cameronl/power-wedge-control-pcb-kicad/bom/rev1/power-wedge-control.ods

Source: | /Users/cameronl/Documents/dev/pcb-kicad/power-wedge-control/power-wedge-control.kicad_sch
Date: | Wednesday, February 23, 2022 at 02:38:49 PM
Tool: | Eeschema (6.0.2-0)
Generator: | /Applications/KiCad/KiCad.app/Contents/SharedSupport/plugins/bom_csv_grouped_by_value_with_fp.py
Component Count: | 90
Ref | Qnty | Value | Cmp name | Footprint | Description | Vendor
C1, C2, | 2 | 470n | C | Capacitor_SMD:C_0603_1608Metric | Unpolarized capacitor
C3, C4, | 2 | NOSTUFF | C | Capacitor_SMD:C_0603_1608Metric | Unpolarized capacitor
C5, C7, C14, | 3 | 10u | C | Capacitor_SMD:C_1206_3216Metric | Unpolarized capacitor
C6, C8, C13, C15, C16, | 5 | 100n | C | Capacitor_SMD:C_0603_1608Metric | Unpolarized capacitor
C9, C10, C11, C12, | 4 | 1uF | C | Capacitor_SMD:C_0603_1608Metric | Unpolarized capacitor
D1, D2, D3, D4, | 4 | LL4148 | D | Diode_SMD:D_MiniMELF | Diode
L1, L2, L3, | 3 | 600R/200mA | L | Inductor_SMD:L_0603_1608Metric | Inductor
LED1, LED2, | 2 | LED | LED | LED_SMD:LED_0603_1608Metric | Light emitting diode
LED3, LED4, | 2 | LED_GRN | LED | LED_SMD:LED_0603_1608Metric | Light emitting diode
Q1, Q3, Q5, Q6, | 4 | MMBT3904L | Q_NPN_BEC | Package_TO_SOT_SMD:SOT-23 | NPN transistor, base/emitter/collector
Q2, Q4, | 2 | DMP3099L | Q_PMOS_GSD | Package_TO_SOT_SMD:SOT-23 | P-MOSFET transistor, gate/source/drain
R1, R4, R11, R12, | 4 | 10k | R | Resistor_SMD:R_0603_1608Metric | Resistor
R2, R5, R9, R10, R13, R14, R21, R22, | 8 | 1k | R | Resistor_SMD:R_0603_1608Metric | Resistor
R3, R6, | 2 | 100k | R | Resistor_SMD:R_0603_1608Metric | Resistor
R7, R8, R23, | 3 | 200k | R | Resistor_SMD:R_0603_1608Metric | Resistor
R15, R17, | 2 | 6.8k | R | Resistor_SMD:R_0603_1608Metric | Resistor
R16, R18, | 2 | 8.2k | R | Resistor_SMD:R_0603_1608Metric | Resistor
R19, R20, R24, | 3 | 4k7 | R | Resistor_SMD:R_0603_1608Metric | Resistor
R25, | 1 | 470 | R | Resistor_SMD:R_0603_1608Metric | Resistor
U1, | 1 | LM1117-5.0 | LM1117-5.0 | Package_TO_SOT_SMD:TO-252-2 | 800mA Low-Dropout Linear Regulator, 5.0V fixed output, TO-220/TO-252/TO-263/SOT-223
U2, U9, | 2 | NC7WZ14P6X | NC7WZ14P6X | Package_TO_SOT_SMD:SOT-363_SC-70-6 | Inverter IC 2 Channel Schmitt Trigger SC-88 (SC-70-6)
U3, | 1 | TLV70233DBV | TLV70233DBV | Package_TO_SOT_SMD:SOT-23-5 | 300 mA Low Dropout Voltage Regulator, Fixed Output 3.3V, SOT-23-5
U4, U7, | 2 | LTV-817S | LTV-817S | Package_DIP:SMDIP-4_W9.53mm | DC Optocoupler, Vce 35V, CTR 50%, SMDIP-4
U5, U6, | 2 | NC7WZ17P6X | NC7WZ17P6X | Package_TO_SOT_SMD:SOT-363_SC-70-6 | Buffer, Non-Inverting 2 Element 1 Bit per Element Push-Pull Output SC-88 (SC-70-6)
U8, | 1 | SN74LVC08ADRG3 | SN74LVC08ADRG3 | Package_SO:SOIC-14_3.9x8.7mm_P1.27mm
U10, U11, | 2 | 74LVC1G32 | 74LVC1G32 | Package_TO_SOT_SMD:SOT-23-5 | Single OR Gate, Low-Voltage CMOS
J9, | 1 | MicroSD_Hirose_DM3D-SF | Micro_SD_Card_Det | Connector_Card:microSD_HC_Hirose_DM3D-SF | Micro SD Card Socket with card detection pins
A1, | 1 | Arduino_UNO_R3 | Arduino_UNO_R3 | Module:Arduino_UNO_R3 | Arduino UNO Microcontroller Module, release 3
J1, | 1 | Conn_01x02 | Conn_01x02 | TerminalBlock_Phoenix:TerminalBlock_Phoenix_PT-1,5-2-3.5-H_1x02_P3.50mm_Horizontal | Generic connector, single row, 01x02, script generated (kicad-library-utils/schlib/autogen/connector/)
J2, J4, J5, | 3 | Conn_01x03 | Conn_01x03 | TerminalBlock_Phoenix:TerminalBlock_Phoenix_PT-1,5-3-3.5-H_1x03_P3.50mm_Horizontal | Generic connector, single row, 01x03, script generated (kicad-library-utils/schlib/autogen/connector/)
J3, | 1 | Conn_01x02 | Conn_01x02 | Connector_PinHeader_2.54mm:PinHeader_1x02_P2.54mm_Vertical | Generic connector, single row, 01x02, script generated (kicad-library-utils/schlib/autogen/connector/)
J6, | 1 | Conn_01x06_Female | Conn_01x06_Female | TerminalBlock_Phoenix:TerminalBlock_Phoenix_PT-1,5-6-3.5-H_1x06_P3.50mm_Horizontal | Generic connector, single row, 01x06, script generated (kicad-library-utils/schlib/autogen/connector/)
J7, | 1 | Conn_01x04_Female | Conn_01x04_Female | TerminalBlock_Phoenix:TerminalBlock_Phoenix_PT-1,5-4-3.5-H_1x04_P3.50mm_Horizontal | Generic connector, single row, 01x04, script generated (kicad-library-utils/schlib/autogen/connector/)
J8, | 1 | Conn_01x04 | Conn_01x04 | Connector_PinHeader_2.54mm:PinHeader_1x04_P2.54mm_Horizontal | Generic connector, single row, 01x04, script generated (kicad-library-utils/schlib/autogen/connector/)
J10, | 1 | Conn_01x10 | Conn_01x10 | Connector_PinHeader_2.54mm:PinHeader_1x10_P2.54mm_Vertical | Generic connector, single row, 01x10, script generated (kicad-library-utils/schlib/autogen/connector/)
J11, | 1 | Conn_01x08 | Conn_01x08 | Connector_PinHeader_2.54mm:PinHeader_1x08_P2.54mm_Vertical | Generic connector, single row, 01x08, script generated (kicad-library-utils/schlib/autogen/connector/)
J12, | 1 | Conn_01x06 | Conn_01x06 | Connector_PinHeader_2.54mm:PinHeader_1x06_P2.54mm_Vertical | Generic connector, single row, 01x06, script generated (kicad-library-utils/schlib/autogen/connector/)
JP1, | 1 | Jumper_2_Open | Jumper_2_Open | Connector_PinHeader_2.54mm:PinHeader_1x02_P2.54mm_Horizontal | Jumper, 2-pole, open
JP2, JP3, | 2 | Jumper_2_Bridged | Jumper_2_Bridged | Jumper:SolderJumper-2_P1.3mm_Bridged_RoundedPad1.0x1.5mm | Jumper, 2-pole, closed/bridged
SW1, | 1 | SW_SPST | SW_SPST | Connector_PinHeader_2.54mm:PinHeader_1x02_P2.54mm_Horizontal | Single Pole Single Throw (SPST) switch
TP1, TP2, TP3, TP4, | 4 | TestPoint | TestPoint | TestPoint:TestPoint_THTPad_D1.5mm_Drill0.7mm | test point
