cameronl/power-wedge-control-pcb-kicad/74LVC08/SN74LVC08ADRG3.step

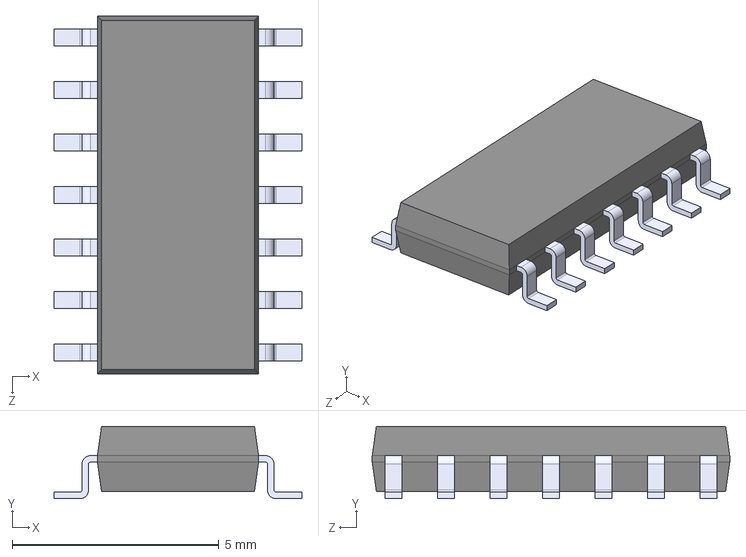
[picture p1: CAD file, 2022-02-04]
74LVC08/SN74LVC08ADRG3.step
6.00 x 1.75 x 8.65 mm
