cameronl/power-wedge-control-pcb-kicad/manual-vs-mcu-relay-control.png

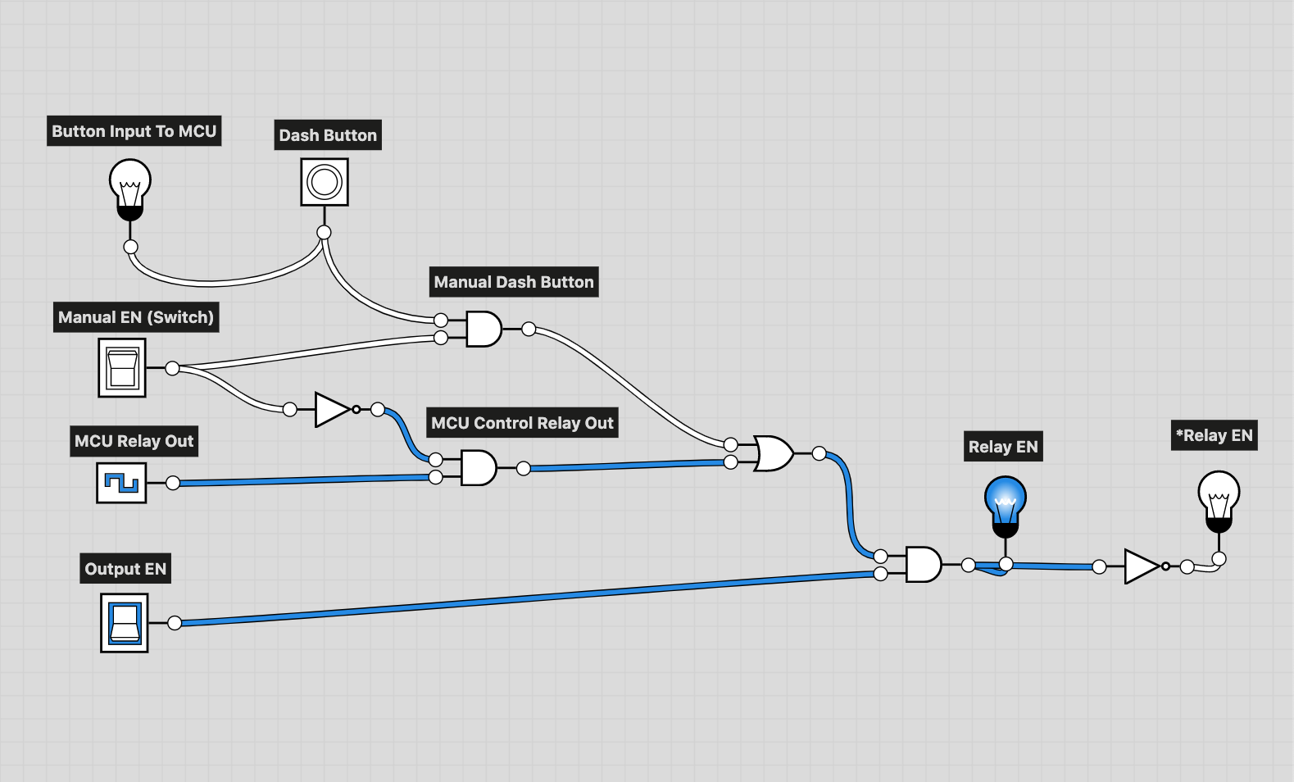
manual-vs-mcu-relay-control.png
