cameronl/power-wedge-control-pcb-kicad/(commit log)

2021-11-25 Initial project with relay control by P-CH FETs.
    [power-wedge-control.kicad_pcb, power-wedge-control.sch]
2021-12-29 KiCad 6. Add 7805 reg, Arduino Uno, ESP32 footprints, angle sensor input
    Add todo notes.
    WIP.
    [power-wedge-control.kicad_pcb, power-wedge-control.kicad_sch, power-wedge-control.sch]
2022-01-02 WIP. Add relay LEDs, ui/display connection.
    [power-wedge-control.kicad_pcb, power-wedge-control.kicad_sch]
2022-01-02 Add output enable, MCU wants relay up/down green LEDs.
    [power-wedge-control.kicad_pcb, power-wedge-control.kicad_sch]
2022-01-03 Line up inverter, output enable transistors.
    [power-wedge-control.kicad_pcb]
2022-01-08 Swap CLK and LE pins on LED UI display connection.
    [power-wedge-control.kicad_pcb, power-wedge-control.kicad_sch]
2022-01-09 Add Up/Down buttons switch input with hardware debounce.
    HW debounce copied from ultrasonic PCB project.
    [hw-debounce.kicad_sch, power-wedge-control.kicad_pcb, power-wedge-control.kicad_sch]
2022-01-09 Fix hardware debounce circuit (was incorrect).
    [hw-debounce.kicad_sch, power-wedge-control.kicad_pcb, power-wedge-control.kicad_sch]
2022-01-09 Flip Arduino UNO R3 footprint.
    [power-wedge-control.kicad_pcb]
2022-01-09 WIP. Line up all connectors along bottom edge.
    Rotate board.
    Focus on Uno R3 for now.
    [power-wedge-control.kicad_pcb]
2022-01-10 More compact.
    [power-wedge-control.kicad_pcb]
2022-01-11 Add design rules, net classes.
    [power-wedge-control.kicad_pcb]
2022-01-11 Connect LED UI display connector to MCU pins.
    [power-wedge-control.kicad_sch]
2022-01-11 Route majority of sensor, button, LED UI traces.
    [power-wedge-control.kicad_pcb]
2022-01-12 Route remaining traces (relay control, 5V).
    Silkscreen clean up.
    [power-wedge-control.kicad_pcb, power-wedge-control.kicad_sch]
2022-01-12 100n on sensor power. Connector silkscreen labels larger (1.5mm)
    [power-wedge-control.kicad_pcb, power-wedge-control.kicad_sch]
2022-01-12 Label connector pins on back silkscreen.
    [power-wedge-control.kicad_pcb]
2022-01-12 Label 5V reg pins, output enable.
    [power-wedge-control.kicad_pcb]
2022-01-15 Add test points for angle sensors. Add todo notes.
    [power-wedge-control.kicad_pcb, power-wedge-control.kicad_sch]
2022-01-16 WIP. Add SD card, 3.3V reg. Move MCU pins for relays, up/down buttons.
    Using 4050 hex buffer to level shift 5V MCU to 3.3V SD card.
    [power-wedge-control.kicad_pcb, power-wedge-control.kicad_sch]
2022-01-16 Switch to NC7WZ17P6X buffers for level shifting to SD card.
    [hw-debounce.kicad_sch, power-wedge-control.kicad_pcb, power-wedge-control.kicad_sch]
2022-01-17 Change 5V regulator LM7805 to LM1117.
    [power-wedge-control.kicad_pcb, power-wedge-control.kicad_sch]
2022-01-18 Flip J3 relay test points away from Uno USB connector.
    [power-wedge-control.kicad_pcb, power-wedge-control.kicad_sch]
2022-01-19 Change 7SegDisp UI connection pin labels for TLC6C5912.
    [power-wedge-control.kicad_pcb, power-wedge-control.kicad_sch]
2022-01-21 Move power supply near angle sensors. Swap several MCU pins.
    Move button debounce up near MCU pins.
    Add top layer zones for thermal at voltage regs.
    [power-wedge-control.kicad_pcb, power-wedge-control.kicad_sch]
2022-01-21 Add ferrite bead on sensor power.
    [power-wedge-control.kicad_pcb, power-wedge-control.kicad_sch]
2022-01-21 Add GND to angle sensor test points.
    [power-wedge-control.kicad_pcb, power-wedge-control.kicad_sch]
2022-01-28 WIP. Add support for active-high (15V max) switch input to schematic.
    [hw-debounce.kicad_sch, power-wedge-control.kicad_pcb, power-wedge-control.kicad_sch]
2022-01-29 Add support for active-high (15V max) switch input to PCB layout.
    [power-wedge-control.kicad_pcb]
2022-02-01 Switch to optocouplers, remove GND-Open option for up/down switch input.
    [power-wedge-control.kicad_pcb, power-wedge-control.kicad_sch]
2022-02-01 Exclude Adafruit Huzzah32 ESP32 from board/bom.
    [power-wedge-control.kicad_pcb, power-wedge-control.kicad_sch]
2022-02-02 Add extra test points for mcu pins, power supply rails.
    Reduce back ground plane clearance.
    [power-wedge-control.kicad_pcb, power-wedge-control.kicad_sch]
2022-02-02 Add 100n on 3V3 at sdcard. More clearance near R21. Fix top zone clearances.
    [power-wedge-control.kicad_pcb, power-wedge-control.kicad_sch]
2022-02-02 Clean up GND via stapling grid on power supply zones.
    [power-wedge-control.kicad_pcb]
2022-02-02 Add front GND zone around angle sensor input.
    [power-wedge-control.kicad_pcb]
2022-02-04 Add hardware manual control option to schematic and WIP layout.
    TODO: 4-wires to up/down buttons: +12V, GND, UP input, DN input.
    TODO: EN manual to MCU input pin.
    TODO: EN manual test/engr pin.
    [SN74LVC08ADRG3.step, power-wedge-control.kicad_pcb, power-wedge-control.kicad_sch]
2022-02-04 Hardware manual control option layout 2.
    [power-wedge-control.kicad_pcb]
2022-02-04 Finish layout for hardware manual control option.
    [power-wedge-control.kicad_pcb]
2022-02-04 Add test point on manual enable and connect to MCU A1 pin.
    [power-wedge-control.kicad_pcb, power-wedge-control.kicad_sch]
2022-02-04 4 wires to up/down buttons: +12V, GND, UP input, DN input.
    Move terminal block pin silkscreen labels away from edge.
    [power-wedge-control.kicad_pcb, power-wedge-control.kicad_sch]
2022-02-04 Add board id & revision, reverse-polarity/unprotected warning on back.
    [power-wedge-control.kicad_pcb]
2022-02-04 Add board name, revision to front silkscreen and title block.
    Extend 5V front filled zone.
    [power-wedge-control.kicad_pcb]
2022-02-05 Add 470 Ω resistor to limit current on +12V pin to up/down buttons.
    [power-wedge-control.kicad_pcb, power-wedge-control.kicad_sch]
2022-02-06 Remove unprotected warning on back.
    [power-wedge-control.kicad_pcb]
2022-02-06 Set Solder Mask Clearance to 0.0508mm
    [power-wedge-control.kicad_pcb]
2022-02-06 Add gerber files for JLCPCB.
    Add order number location on back silkscreen.
    [power-wedge-control-B_Cu.gbl, power-wedge-control-B_Mask.gbs, power-wedge-control-B_Paste.gbp, power-wedge-control-B_Silkscreen.gbo, power-wedge-control-Edge_Cuts.gm1, power-wedge-control-F_Cu.gtl, power-wedge-control-F_Mask.gts, power-wedge-control-F_Paste.gtp]
2022-02-25 Add Bill Of Materials (BOM) for rev1.
    [power-wedge-control.kicad_sch, power-wedge-control.ods]
2022-02-25 Fix (swap) R17, R18 silkscreen references.
    [power-wedge-control.kicad_pcb]
2022-02-25 Update value for SN74LVC1G32 to specific part.
    [power-wedge-control.kicad_pcb, power-wedge-control.kicad_sch]
2022-03-01 Add pull-down resistors on relay up+down pins from MCU.
    [power-wedge-control.kicad_pcb, power-wedge-control.kicad_sch]
2022-03-29 Add todo notes.
    [power-wedge-control.kicad_sch]
2023-03-07 KiCad 7
    [hw-debounce.kicad_sch, power-wedge-control.kicad_pcb, power-wedge-control.kicad_sch]
